bigtreetech/ramps-1.6/Ramps1.6/Wiring diagram/A749~QCUG2KA)E{{77VMKYV.jpg

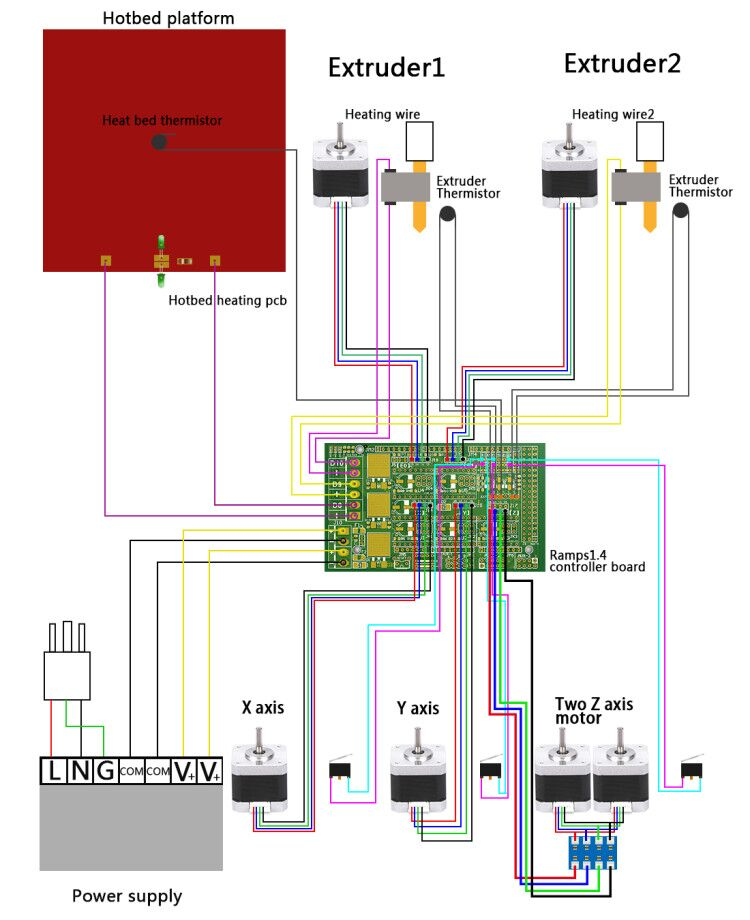
Ramps1.6/Wiring diagram/A749~QCUG2KA)E{{77VMKYV.jpg
