bigtreetech/ramps-1.6/Ramps1.6/Motherboard image/2.jpg

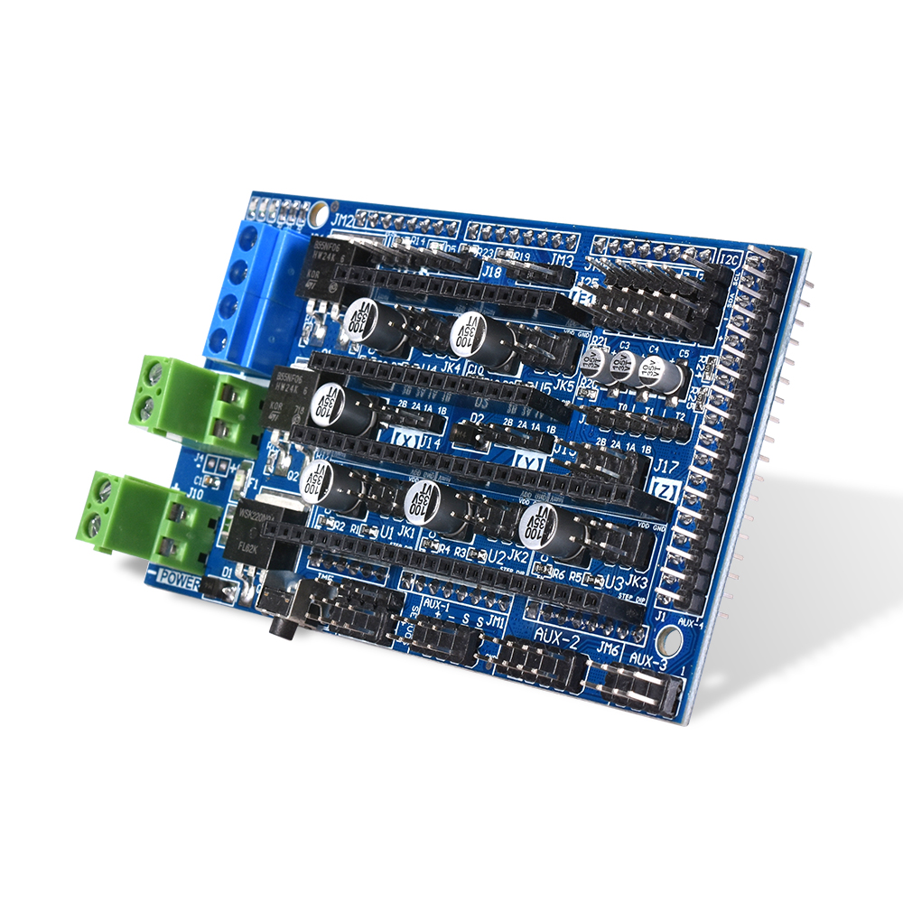
Ramps1.6/Motherboard image/2.jpg
