bigtreetech/ramps-1.6/Ramps1.6/BOM form/BQ105-A4 【RAMPS 1.6】Interface board R6  BOM form.xls

BQ105-A4【RAMPS 1.6】主板接口板R6 BOM表
物料编码 | 元件型号 | 元件丝印 | 封装 | 数量 | 备注
DDR000001 | 0.1UF/50V | C1 | 0603N | 1 | 贴片电容
DDR000012 | 35V/100UF | C2, C6, C7, C8, C9, C10 | 35V/100UF-2 | 6 | 贴片电容
DDR000040 | 35V/10UF | C3, C4, C5 | 35V/10UF | 3 | 贴片电容
DRJ000005 | IN4004【M4】 | D1, D2 | DO-214AC | 2 | 贴片二极管
DLE000008 | LED | D3, D4, D5, D6 | LED-0603 | 4 | 贴片蓝灯
DBX000003 | 30A【16V 30A】 | F1 | 1206 | 1 | 贴片保险丝
DBX000007 | MFR500 【30V 5A】 | F2 | 1206 | 1 | 贴片保险丝
DPZ000029 | SIP36 | J1 | 2.54-36 | 1 | 插件双排排针
DPZ000032 | AUX-4 | J2 | SIP18 | 1 | 插件单排排针
DPZ000027 | SER1 | J3 | SIP3 | 1 | 插件单排4P排针 + 插件Header2*4P
 | SER2 | J7 | SIP3 | 1
DPZ000025 | SER3 | J11 | SIP3 | 1
 | SER4 | J13 | SIP3 | 1
 | 12V-AUX | J4 | SIP2 | 1 | 不装
DPZ000031 | 3P | J5 | SIP3 | 1 | 插件单排排针
DPZ000025 | SERIAL | J6 | 2.54-4 | 1 | 插件Header2*4P
 | A-OUT | J12 | 2.54-4 | 1
DPZ000026 | AUX-2 | J8 | Header2*5 | 1 | 插件双排排针
DPZ000025 | AUX-3 | J9 | Header4*2 | 1 | 插件双排排针
DPZ000008 | 300V/20A | J10, J28 | 5.08-2 | 2 | 插件电源端子
DPZ000027 | X-MOT | J14 | SIP4 | 1 | 插件单排排针
 | Y-MOT | J15 | SIP4 | 1
 | Z-MOT | J16, J17 | SIP4 | 2
 | E0-MOT | J18 | SIP4 | 1
 | E1-MOT | J25 | SIP4 | 1
 | I2C | J29 | SIP4 | 1
DPZ000002 | X- | J19 | SIP3 | 1 | 插件单排6P排针+插件Header2*6P
 | X+ | J20 | SIP3 | 1
 | Y- | J21 | SIP3 | 1
DPZ000030 | Y+ | J22 | SIP3 | 1
 | Z- | J23 | SIP3 | 1
 | Z+ | J24 | SIP3 | 1
DPZ000113 | 5.08-4 | J26 | 5.08-4-B | 1 | 插件接线端子
DPZ000002 | 6P | J27 | 2.54-6 | 1 | 插件单排针座
DPZ000009 | JP6 | JK1, JK2, JK3, JK4, JK5 | Header3*2 | 5 | 插件双排针座
DPZ000001 | 8P | JM1, JM2, JM3, JM4, JM6 | SIP8 | 5 | 插件单排针座
DPZ000002 | 6P | JM5 | SIP6 | 1 | 插件单排针座
DKG000003 | RESET | K1 | K7 | 1 | 插件复位开关
DSJ000006 | STP55NF06 | Q1, Q2 | TO-263-M | 2 | 贴片MOS管
DSJ000008 | WSK220N04 | Q3 | TO-263-M | 1 | 贴片MOS管
DDZ000004 | 100K/±1% | R1, R3, R5, R7, R9, R13, R17, R23 | 0603N | 8 | 贴片电阻
DDZ000006 | 10K/±1% | R2, R4, R6, R8, R10 | 0603N | 5 | 贴片电阻
DDZ000024 | 10R/±1% | R11, R15, R19 | 0603N | 3 | 贴片电阻
DDZ000023 | 1.8K/±1% | R12, R16, R18 | 0603N | 3 | 贴片电阻
DDZ000005 | 1K/±1% | R14 | 0603N | 1 | 贴片电阻
DDZ000008 | 4.7K/±1% | R20, R21, R22, R24, R25 | 0603N | 5 | 贴片电阻
DIC000001 | A4988 | U1, U2, U3, U4, U5 | A4988-2 | 5 | 单排母16P插座2个+单排母24P插座2个
WSR000019 | 散热器 | 【长60MM*宽10MM*高10MM】 |  | 1 | 客户自选配件 【如果热床≤1Ω建议用】
DPC000096 | PCB | BQ105-A4【RAMPS 1.6】 |  | 1 | 空板
 | 制表：李荣强 |  | 时间: 2017.12.12
