bigtreetech/ramps-1.6/Ramps1.6/hardware/R6+-SCH.pdf

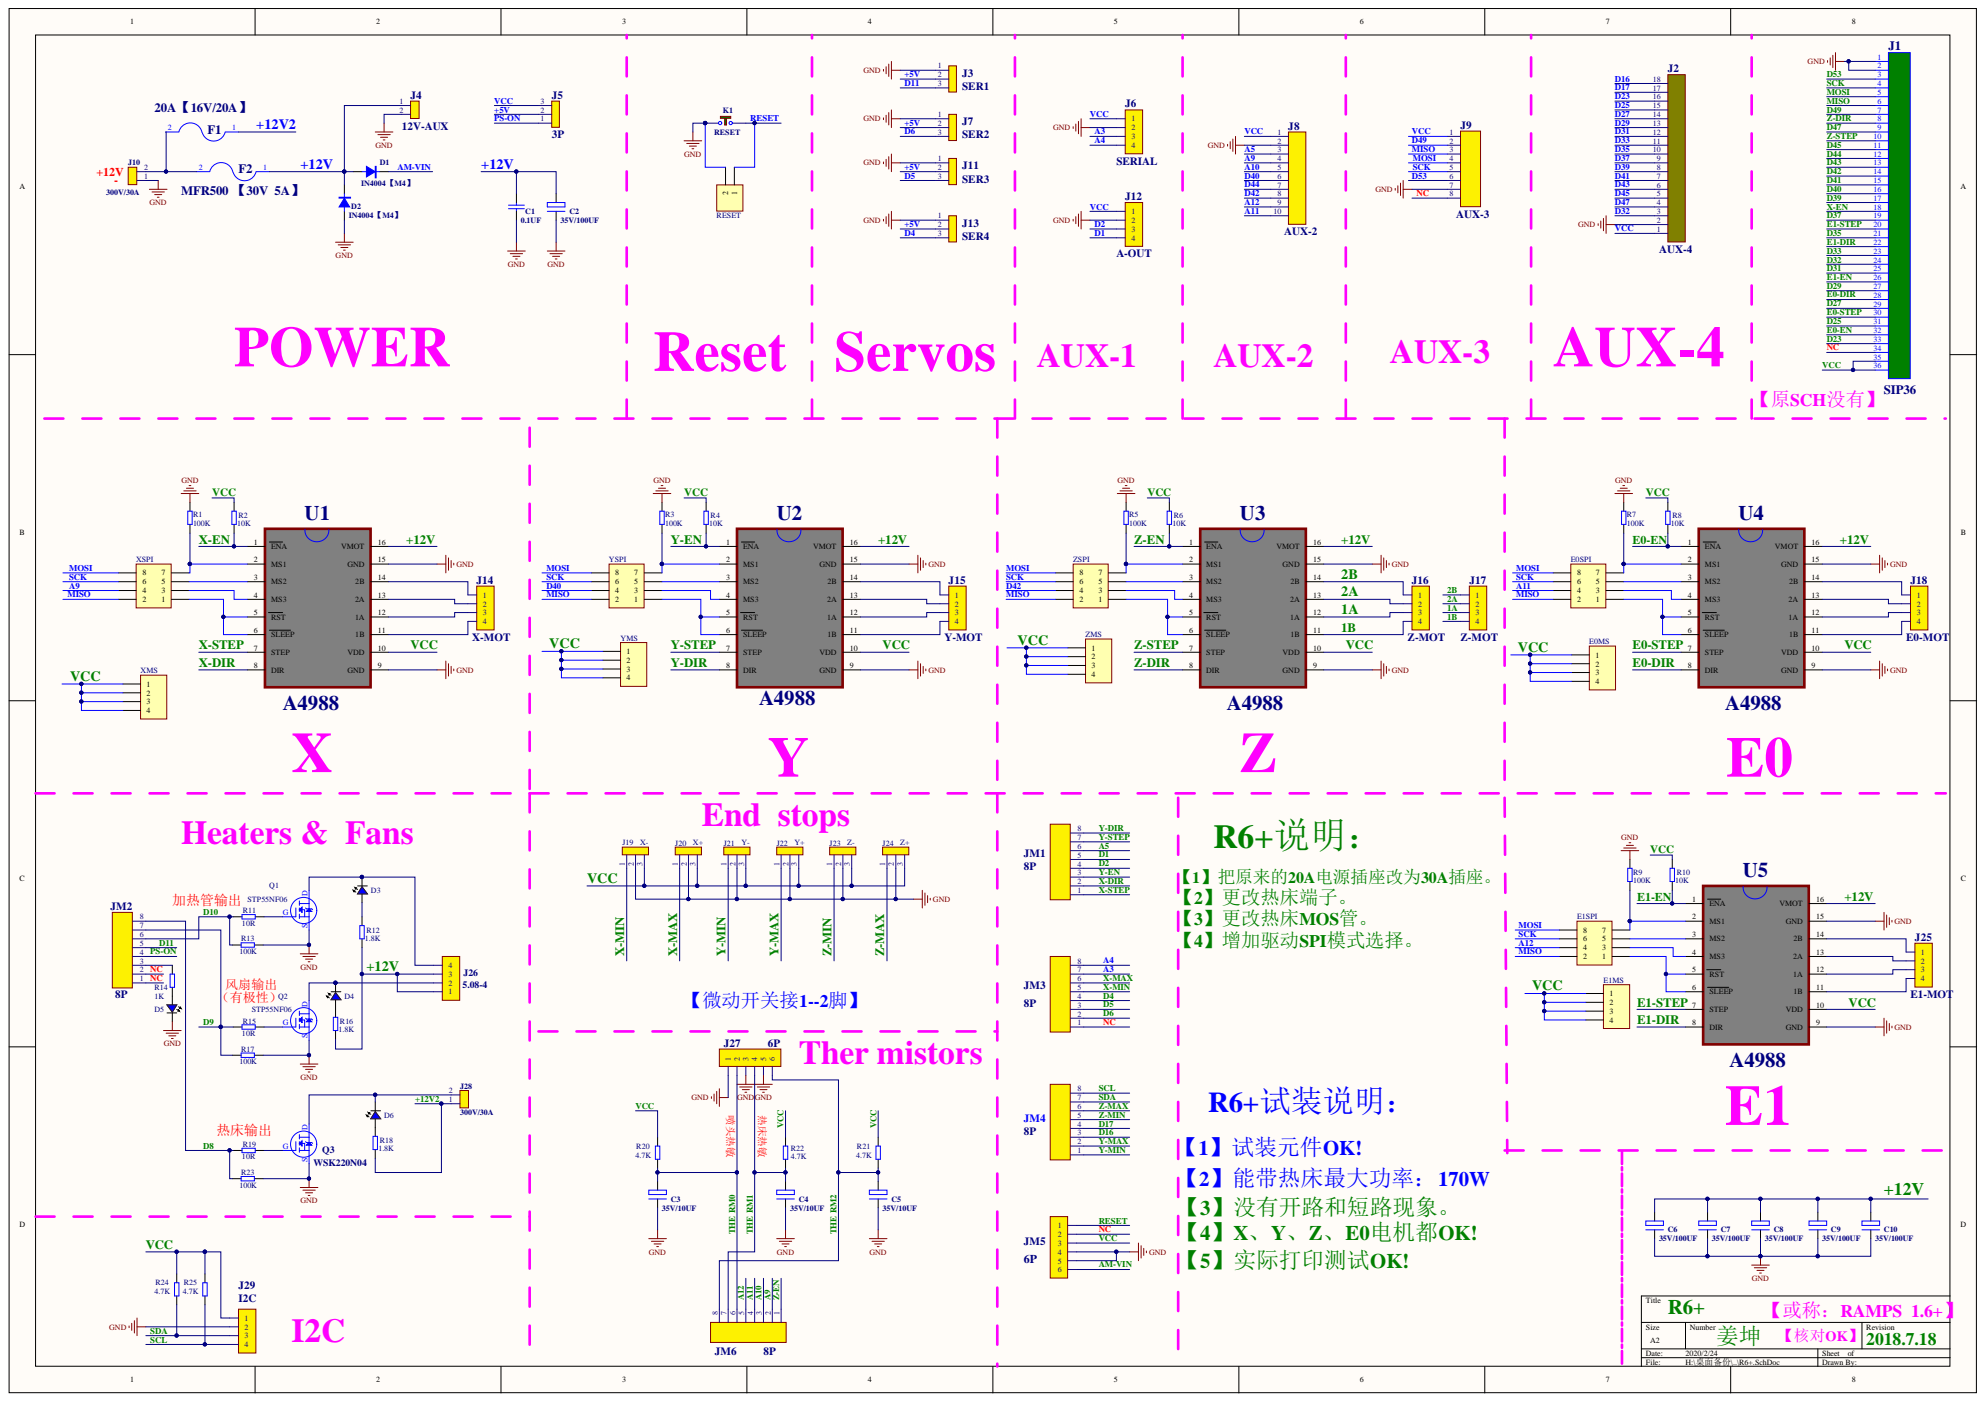
[picture p3: page 1]

End stops Heaters & Fans
