bigtreetech/ramps-1.6/Ramps1.6/hardware/R6Schematic diagram.pdf

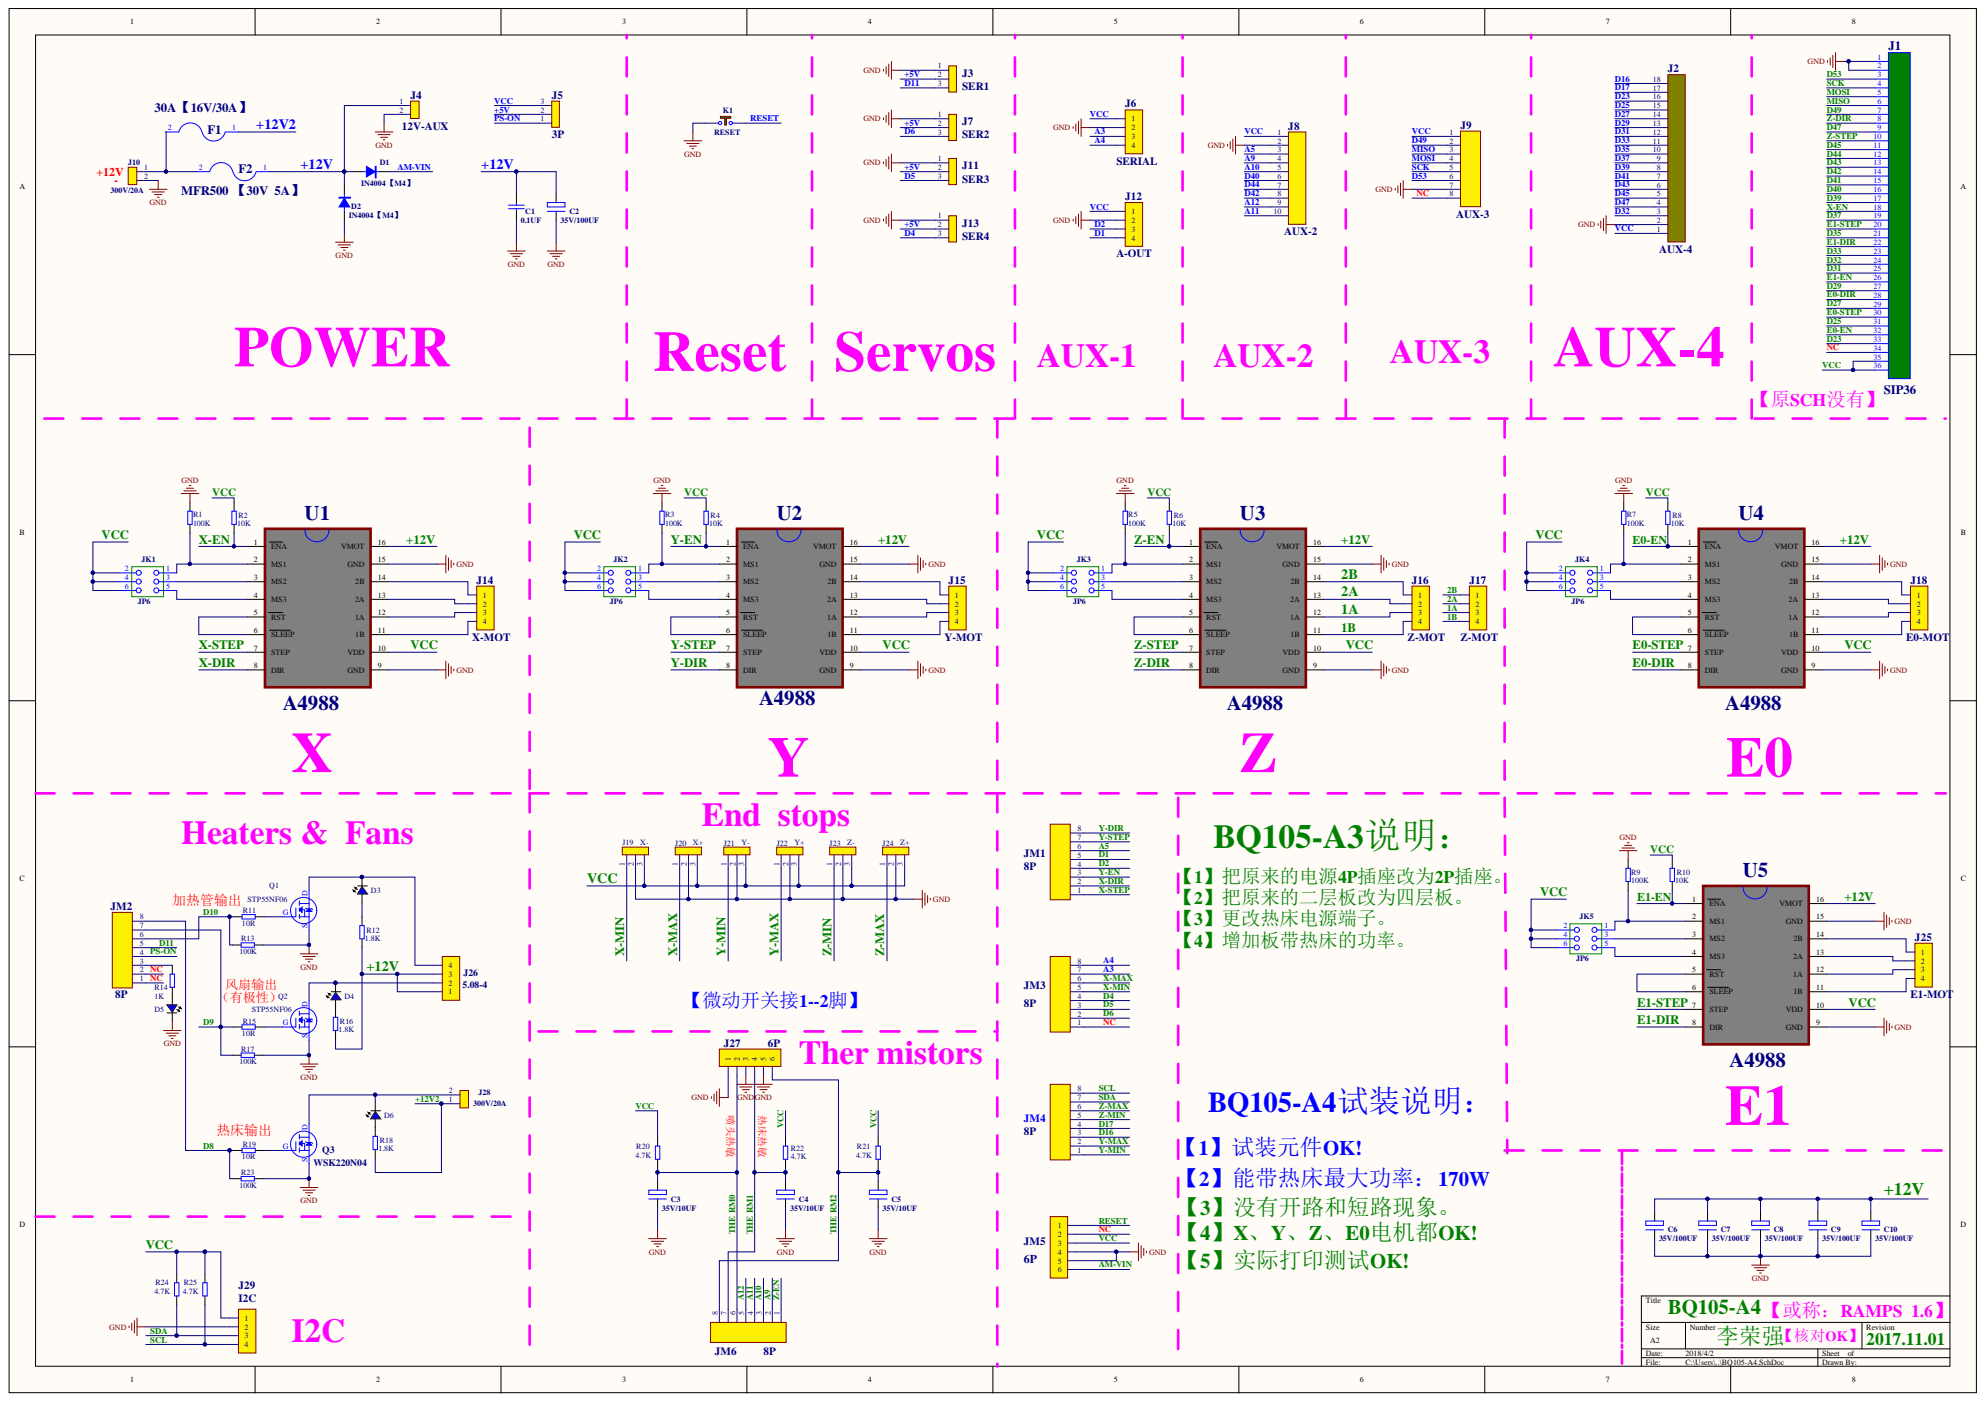
[picture p4: page 1]

End stops Heaters & Fans
