bigtreetech/ramps-1.6/Ramps1.6/Two-dimensional map/BQ105-A4Silk screen.pdf

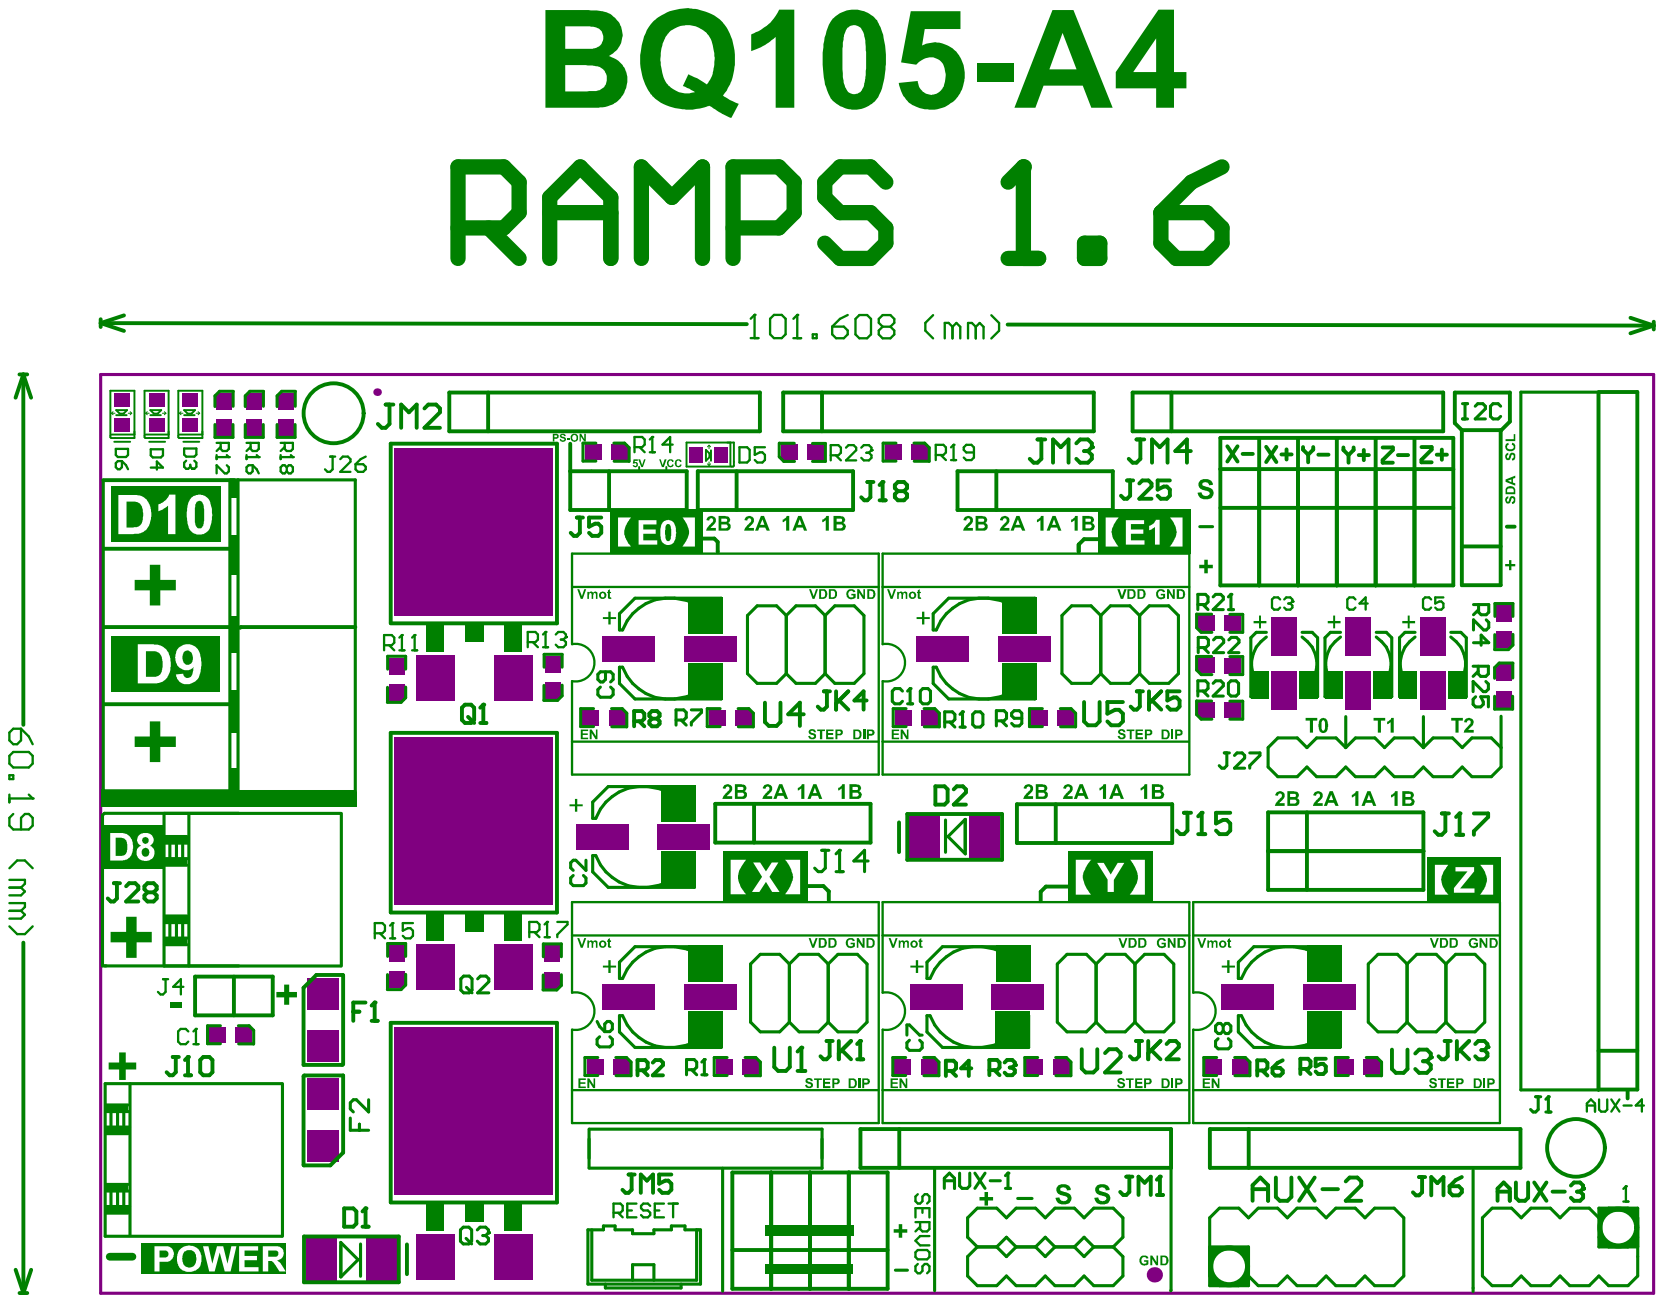
[picture p5: page 1]
