bigtreetech/ramps-1.6/(list of files, drawings)

Other design files:
Ramps1.6/hardware/BQ105-A4.SchDoc
Ramps1.6/hardware/R6.PcbDoc
