bigtreetech/ramps-1.6/(threads)

Thread 3 (2018-12-21):

Please post ramps 1.6 plus

drmulligan, 2018-12-21:
bigtreetech is now selling the ramps 1.6 plus with integrated SPI lines for tmc2130.

Please be aware that the SPI lines for the TMC2130 does not work with the Re-Arm board as D40, D42, D65 and D66 are missing.  The situation is worse if you are using a RRD Full Graphics LCD as it doesn't share SPI lines well, or at least in Marlin 2.0 this isn't working and there is a sanity check preventing the configuration from even compiling.   I would love to know how to disconnect MOSI, MISO and SCK from the driver sockets so that I only have to plug them into one of the driver sockets.  I still want those 3 lines to go to AUX3 for the LCD though.

olioli2345, 2019-01-06:
@drmulligan - have you managed to get anything working with the 1.6+? I, too, have purchase it from China, yet there is no documentation or guidance on setting up Marlin anywhere.

ax00b3, 2019-05-01:
I didn't understand anything from Alex's video, is there a step by step guide?

EsserPrototyping, 2019-06-23:
Can’t help with the display, but I’ve managed to get rearm and ramps 1.6 plus with tmc2130 running with spi. I have disconnected the CS lines by removing the jumpers, defined them on other free pins and connected them via jumper cables. In marlin i have defined software spi, but giving the software pins the same as the original.. (D50, D51, D52 ... translated to the rearm board.. i don’t know them right know)
I can’t tell if this is the smart way, but i think the compiler will understand that redefining hardware spi pins as software spi pins is useless and use them as normal. However, onboard spi without jumper cables for mosi, miso and sck is working with this setting. Maybe this problem is solved since it’s not the latest version of marlin i am using.

drmulligan, 2019-07-04:
@EsserPrototyping I assume this means you do not have a RRD LCD display then.  There are two problems with RE-ARM and this board, one you've addressed with missing lines used for CS.  The other is MOSI, MOSO and SCK cannot be shared with the LCD.  The problem is RRD LCD boards use a controller which does not honour it's CS signal chatting on the other 3 when it's not supposed to.

EsserPrototyping, 2019-07-04:
Yes, i don´t use a LCD. I´m using this board for a pick and place machine.. but after installing the skr 1.3 in my printer, i think you can have a look at the pin mapping of the skr 1.3, because it´s the same cpu, there is maybe a way to copy the spi pin mapping and use jumper wires for spi to the drivers too.
In general, replacing the re-arm + ramps combo with the skr 1.3 is probably the better solution if the LCD is working with it. (The time it will take to make the ramps work is maybe more expensive than ordering the new board)
I´m swithing to the skr pro with my pick and place, because i need 6 axies.

Thread 7 (2019-07-28):

Error Compiling

DJKyomi, 2019-07-28:
sketch/Marlin_main.cpp: In function 'void set_bed_level_equation_lsq(double*)':
sketch/Marlin_main.cpp:831:36: warning: ISO C++ forbids converting a string constant to 'char*' [-Wwrite-strings]
     planeNormal.debug("planeNormal");

Timoms, 2020-03-05:
For future visitors: Use Arduino 1.0.6.
Should compile fine.

Thread 8 (2020-04-26):

Enabling 5v on ramps 1.6+ ??

davidmarli, 2020-04-26:
Hi,

I want to connect a bltouch probe on ramps 1.6+ (with rearm 32 bit card).
In marlin 2.0.x I define : #define Z_MIN_PROBE_PIN 11
So I plug the orange cable of 3dtouch on the first pin of servos.

Where must I connect the red and brown cable ?
And the white and black cable ?  in z min ?

My question is about the jumper between 5v and vcc (next to the extruder driver)
Must I leave it or not ?

What does this jumper do ?

Thank you.

venuasg, 2020-09-24:
Facing the same issue...

jalanjarosz, 2020-09-24:
The RE-ARM is based on a MCU that operates on 3v3 logic, not 5v like the MEGA, or even DUE.

The RAMPS board has two voltage channels; High Voltage (typically 12v) and Logic Voltage (3.3v or 3v3 for the RE-ARM).  Logic voltage is needed to trigger end-stops, heaters, and other accessories.  side note: I suggest to use the on-board thermister connections on the RE-ARM over the RAMPS.

The RE-ARM has 3 voltage channels in order to attempt to make it 'compatible" with the MEGA.  the RE-ARM has the input voltage at the barrel jack, a 5v rail, and a 3v3 logic rail.   The 5v rail is for some plug-in accessories.

The above is why the RE-ARM has an optional display cable for the RRD displays, so that you can pull the needed 5v off of a different header pin over the RRD adapter, which has 3v3 feeding it.

Add in your BLTouch/Clone..   There are two operating modes; 5v (default) and 3v3 which is typically selectable via a trace that is either soldered or cut on the sensor.  BLTouch/clones have two distinct voltage requirements; Logic and Actuator.  Logic is has selectable via the trace and the Actuator requires 5v.   Thankfully the RE-ARM end-stop pins (+/- X, Y, and Z) are all 5v tolerant. But you still need to supply 5v to the Actuator.

Luckily, you can pull 5v off the RE-ARM board itself.  You can pull the needed 5v from the UART, J3, or J12 headers.  See the Panucatt pinout link below.

Good luck, hope this helps.

https://s3.amazonaws.com/cdn.freshdesk.com/data/helpdesk/attachments/production/1047536701/original/Re-ARM%20pinouts.pdf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

venuasg, 2020-09-24:
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

Thanks for the reply, frankly i did not get your point. And also you link not opening.

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

jalanjarosz, 2020-09-24:
@venuasg, you have different voltages between the RE-ARM and the Arduino MEGA.

The RAMPS board was designed to interface with the MEGA, which uses 5v logic,   The MEGA (MCU) Logic voltage is brought up from the MEGA to the RAMPS board.   When J5 is has a jumper (where you point in your image) you get the 5v Logic voltage at the SERVO pins across the board (next to the reset button) on a MEGA/RAMPS stack.

RE-ARM (MCU) boards use 3.3v (3v3) Logic, so that logic voltage is now running though the RAMPS board on a RE-ARM/RAMPS stack.  So if/when you jumper J5 (pins in your image), you will get 3.3v at SERVO pins next to the reset button.

There no "out of the box" way to plug a 5v servo into the RAMPS board using the RE-ARM logic voltage to get it to work.

You have to pull the needed 5v that the BLTouch servo needs from a 5v source.  Two ways, 1) you can pull from one of 3 pins directly off the RE-ARM board, or you have to use an external 5v source.

Sorry that the link did not work.  Try this one: http://panucattdevices.freshdesk.com/support/solutions/articles/1000242059-support-files
Then click on the "Re-ARM pinouts.pdf" link to get the location of the 5v pins on the Re-ARM board.  You can use one of the three to provide the needed 5v to your BLTouch servo.

-James

venuasg, 2020-09-25:
Thanks James, I could not get through as i am using RAMPS 1.6 with Arduino Mega 2560. Bit confused.

Geronkie, 2020-12-24:
Hi there thank you for your work but please can you identify J3 on this board

Galneyordo, 2021-02-01:
Hi everyone!

I also have a problem with the BLtouch.
When I use the jumper on 5V and VCC the RAMPs 1.6 turn off, and I can't connect my computer to the 3D printer.
Then when I take off the jumper, the RAMPs turn on and I can connect the printer.

Does anyone know why it doesn't work?

venuasg, 2021-02-01:
Hi,
Connect the BL Touch on your RAMPS 1.6 as per below stated pins and remove the jumper that you have connected.

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

Make sure you have enabled BLTOUCH in marlin.

Galneyordo, 2021-02-01:
Hello,

Thanks for your help Venuasg. So your technique seems to work, because the BLtouch is on, but I still have a problem because Z axis doesn't stop when BL touch touch the bed, but that's probably because of the program on Repetier.

And I still don't know why the jumper turn off the RAMPs. Do you have an idea about that? Because I also would like to use the RRD fan extender on "servos", but if I don't have the 5V it won't work?

venuasg, 2021-02-02:
Hi,
Good to know it worked, For BL Touch to work you need to check Repetier configuration, as I have not configured in Repetier could not help you much.
For RAMPS on the RAMPS board the jumper pins are not taken care in the design, hence you need to ignore pluging in the jumper on the RAMPS. Do not spend much on thinking why it is not working all i say is to ignore. I have spent much time on this without any solution.

RobMitshi, 2023-06-17:
hi, I would like to add this ReArm pinout, in case anyone stumbles on this topic and is in dire need of the REARM pins.
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
Have a great day, greets, RMM Radionica

Eugeniusz-Gienek, 2024-03-21:
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

The same jumper for RAMPS 1.5. Thank You man!!!!

Thread 9 (2021-04-18):

Servo enable cause a short-circuit

patmmm, 2021-04-18:
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

I found a short circuit between ground plane and servo+ line.

Closed 2022-02-22.

Thread 10 (2021-05-29):

Compiling Error

esis94, 2021-05-29:
```
Arduino: 1.8.15 (Windows 10), Board: "Arduino Mega or Mega 2560, ATmega2560 (Mega 2560)"

C:\Users\Dynamix\Desktop\Wiring & Marlin Firmware\ramps-1.6-master\ramps-1.6-master\Ramps1.6\firmware\Marlin\Marlin_main.cpp:2208:36: warning: invalid suffix on literal; C++11 requires a space between literal and string macro [-Wliteral-suffix]

         LCD_MESSAGEPGM(MACHINE_NAME" "MSG_OFF".");

                                    ^

In file included from C:\Users\Dynamix\Desktop\Wiring & Marlin Firmware\ramps-1.6-master\ramps-1.6-master\Ramps1.6\firmware\Marlin\SdFile.h:27:0,

                 from C:\Users\Dynamix\Desktop\Wiring & Marlin Firmware\ramps-1.6-master\ramps-1.6-master\Ramps1.6\firmware\Marlin\cardreader.h:8,

                 from C:\Users\Dynamix\Desktop\Wiring & Marlin Firmware\ramps-1.6-master\ramps-1.6-master\Ramps1.6\firmware\Marlin\Marlin_main.cpp:46:

SdBaseFile.h:38:8: error: using typedef-name 'fpos_t' after 'struct'

 struct fpos_t {

        ^~~~~~

In file included from C:\Users\Dynamix\Desktop\Wiring & Marlin Firmware\ramps-1.6-master\ramps-1.6-master\Ramps1.6\firmware\Marlin\Marlin.h:10:0,

                 from C:\Users\Dynamix\Desktop\Wiring & Marlin Firmware\ramps-1.6-master\ramps-1.6-master\Ramps1.6\firmware\Marlin\Marlin_main.cpp:32:

c:\program files (x86)\arduino\hardware\tools\avr\avr\include\stdio.h:950:33: note: 'fpos_t' has a previous declaration here

 __extension__ typedef long long fpos_t;

                                 ^~~~~~

C:\Users\Dynamix\Desktop\Wiring & Marlin Firmware\ramps-1.6-master\ramps-1.6-master\Ramps1.6\firmware\Marlin\Marlin_main.cpp: In function 'void set_bed_level_equation_lsq(double*)':

C:\Users\Dynamix\Desktop\Wiring & Marlin Firmware\ramps-1.6-master\ramps-1.6-master\Ramps1.6\firmware\Marlin\Marlin_main.cpp:831:36: warning: ISO C++ forbids converting a string constant to 'char*' [-Wwrite-strings]

     planeNormal.debug("planeNormal");

                                    ^

In file included from C:\Users\Dynamix\Desktop\Wiring & Marlin Firmware\ramps-1.6-master\ramps-1.6-master\Ramps1.6\firmware\Marlin\SdBaseFile.cpp:24:0:

SdBaseFile.h:38:8: error: using typedef-name 'fpos_t' after 'struct'

 struct fpos_t {

        ^~~~~~

In file included from C:\Users\Dynamix\Desktop\Wiring & Marlin Firmware\ramps-1.6-master\ramps-1.6-master\Ramps1.6\firmware\Marlin\Marlin.h:10:0,

                 from C:\Users\Dynamix\Desktop\Wiring & Marlin Firmware\ramps-1.6-master\ramps-1.6-master\Ramps1.6\firmware\Marlin\SdBaseFile.cpp:21:

c:\program files (x86)\arduino\hardware\tools\avr\avr\include\stdio.h:950:33: note: 'fpos_t' has a previous declaration here

 __extension__ typedef long long fpos_t;

                                 ^~~~~~

C:\Users\Dynamix\Desktop\Wiring & Marlin Firmware\ramps-1.6-master\ramps-1.6-master\Ramps1.6\firmware\Marlin\SdBaseFile.cpp: In member function 'void SdBaseFile::getpos(fpos_t*)':

SdBaseFile.cpp:298:8: error: request for member 'position' in '* pos', which is of non-class type 'fpos_t {aka long long int}'

   pos->position = curPosition_;

        ^~~~~~~~

SdBaseFile.cpp:299:8: error: request for member 'cluster' in '* pos', which is of non-class type 'fpos_t {aka long long int}'

   pos->cluster = curCluster_;

        ^~~~~~~

C:\Users\Dynamix\Desktop\Wiring & Marlin Firmware\ramps-1.6-master\ramps-1.6-master\Ramps1.6\firmware\Marlin\SdBaseFile.cpp: In member function 'void SdBaseFile::setpos(fpos_t*)':

SdBaseFile.cpp:1496:23: error: request for member 'position' in '* pos', which is of non-class type 'fpos_t {aka long long int}'

   curPosition_ = pos->position;

                       ^~~~~~~~

SdBaseFile.cpp:1497:22: error: request for member 'cluster' in '* pos', which is of non-class type 'fpos_t {aka long long int}'

   curCluster_ = pos->cluster;

                      ^~~~~~~

In file included from C:\Users\Dynamix\Desktop\Wiring & Marlin Firmware\ramps-1.6-master\ramps-1.6-master\Ramps1.6\firmware\Marlin\SdFile.h:27:0,

                 from C:\Users\Dynamix\Desktop\Wiring & Marlin Firmware\ramps-1.6-master\ramps-1.6-master\Ramps1.6\firmware\Marlin\SdFile.cpp:23:

SdBaseFile.h:38:8: error: using typedef-name 'fpos_t' after 'struct'

 struct fpos_t {

        ^~~~~~

In file included from C:\Users\Dynamix\Desktop\Wiring & Marlin Firmware\ramps-1.6-master\ramps-1.6-master\Ramps1.6\firmware\Marlin\Marlin.h:10:0,

                 from C:\Users\Dynamix\Desktop\Wiring & Marlin Firmware\ramps-1.6-master\ramps-1.6-master\Ramps1.6\firmware\Marlin\SdFile.cpp:20:

c:\program files (x86)\arduino\hardware\tools\avr\avr\include\stdio.h:950:33: note: 'fpos_t' has a previous declaration here

 __extension__ typedef long long fpos_t;

                                 ^~~~~~

exit status 1

using typedef-name 'fpos_t' after 'struct'

This report would have more information with
"Show verbose output during compilation"
option enabled in File -> Preferences.

```

esis94, 2021-05-29:
![Uploading 43435435445.jpg…]()

esis94, 2021-05-29:
![Uploading 43435435445.jpg…]()

Thread 11 (2022-02-06):

Run Nema 23 with TB6560

luca920, 2022-02-06:
Hi,
what kind of configuration sholud I use to run a set of Nema 23 with external driver?
 I found online a wiring scheme like this on instructable for a RAMPS 1.4 and I also localized the right pins, but with repetier firmware it is not working.
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

It is possible is not suitable for this newer version?

Is the wiring anyway correct or should I change something?

Thread 12 (2022-08-19):

12 V not connected

beebrain, 2022-08-19:
I bougth ramps 1.6 that the same design in this pcb layout.
I saw some power line 12v are not connected. Be careful if you buy this version.

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

AntFerreiro, 2023-12-08:
> I bougth ramps 1.6 that the same design in this pcb layout. I saw some power line 12v are not connected. Be careful if you buy this version.
>
> 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

Do you have a library for the schematics desing of the ramps?
